sascha432/pizero-doorspy/stl/doorspy-housing-led-cover.stl

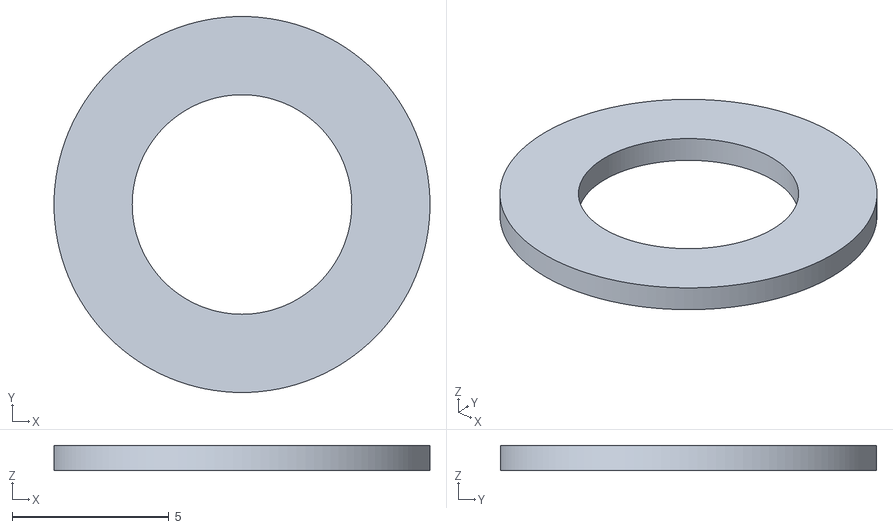
[picture p2: CAD file, 2026-10-21]
stl/doorspy-housing-led-cover.stl
12.0 x 12.0 x 0.8
