sascha432/pizero-doorspy/stl/doorspy-housing-backplate.stl

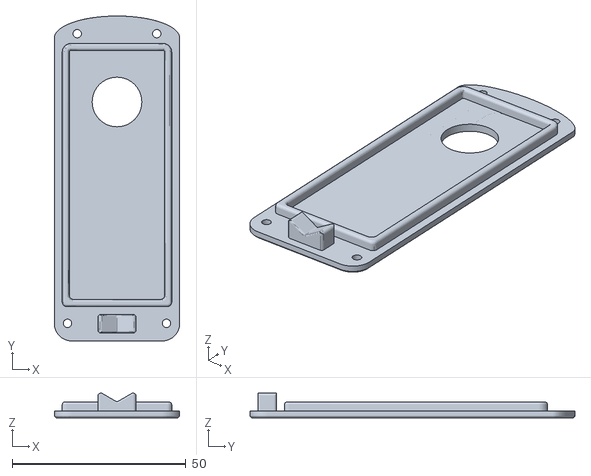
[picture p3: CAD file, 2026-10-21]
stl/doorspy-housing-backplate.stl
36.1 x 93.4 x 7.11
