sascha432/pizero-doorspy/stl/doorspy-housing-body.stl

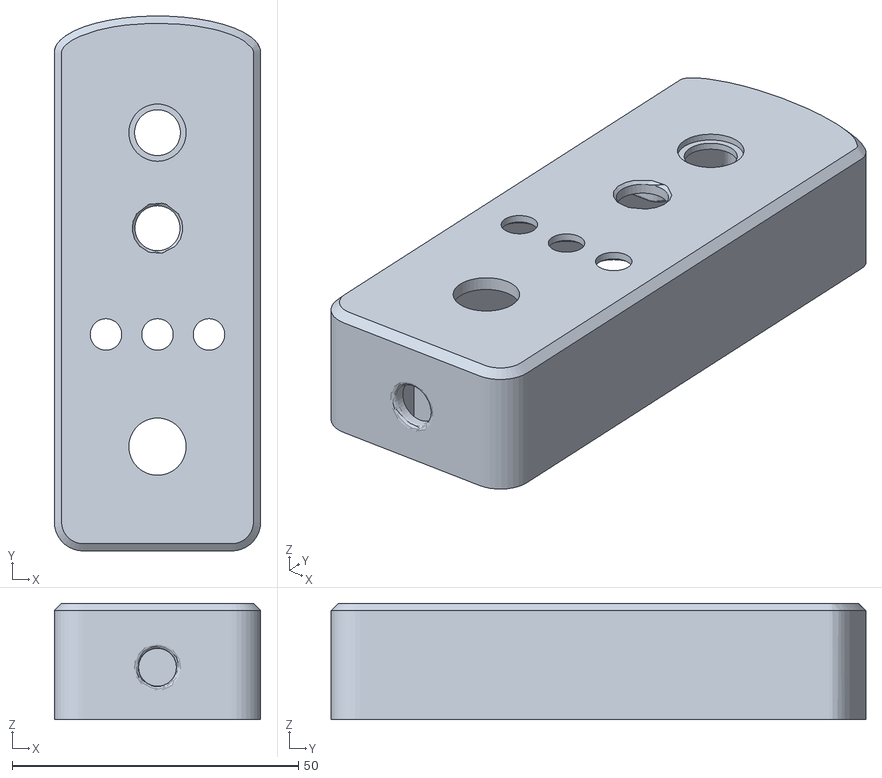
[picture p4: CAD file, 2026-10-21]
stl/doorspy-housing-body.stl
36.1 x 93.5 x 20.3
