sascha432/pizero-doorspy/stl/doorspy-housing-cam-cover.stl

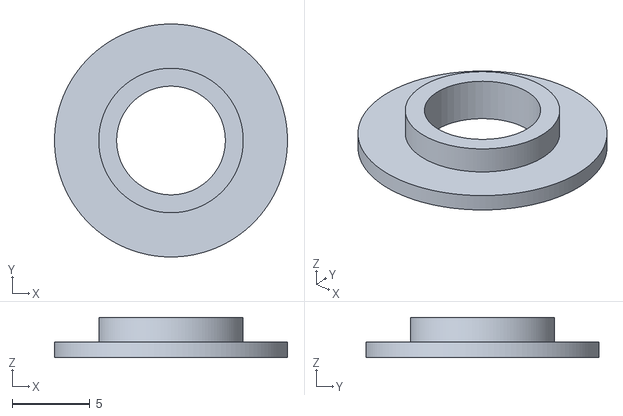
[picture p5: CAD file, 2026-10-21]
stl/doorspy-housing-cam-cover.stl
15.0 x 15.0 x 2.60
