sascha432/pizero-doorspy/stl/peephole-hollow-bolt-M12-nut.stl

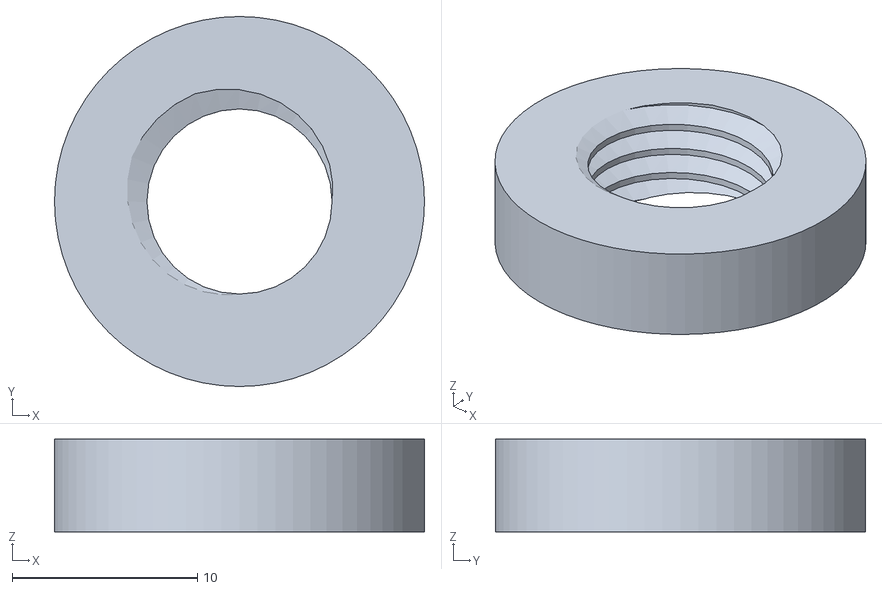
[picture p6: CAD file, 2026-10-21]
stl/peephole-hollow-bolt-M12-nut.stl
20.0 x 20.0 x 5.00
