sascha432/pizero-doorspy/stl/peephole-hollow-bolt-M12-56mm.stl

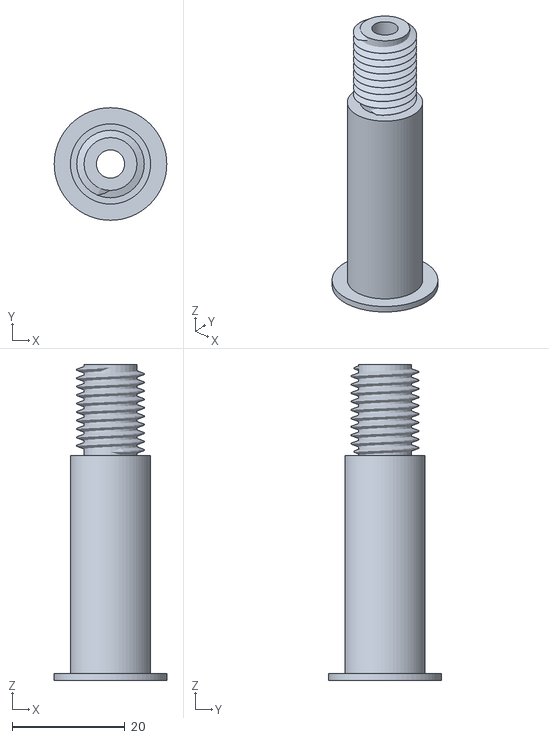
[picture p7: CAD file, 2026-10-21]
stl/peephole-hollow-bolt-M12-56mm.stl
20.0 x 20.0 x 56.1
