sascha432/pizero-doorspy/(commit log)

2026-10-21 doorspy: Pi Zero W door camera with web UI, Frigate gating and lights
    Camera service (Picamera2 -> H.264 to MediaMTX, MJPEG/snapshot on :8080 with
    Basic auth), web UI on :8443 (HTTPS, live image controls, stream settings,
    lights, Frigate modes, system), doorspy-io (power LED, WS2812 status indicator,
    button, PIR, per-function Frigate gate incl. the camera-enable switch, CPU
    temperature on MQTT), installer, Frigate config for the Pi 4, docs, case STLs.
    [doorspy-housing-backplate.stl, doorspy-housing-body.stl, doorspy-housing-cam-cover.stl, doorspy-housing-led-cover.stl, peephole-hollow-bolt-M12-56mm.stl, peephole-hollow-bolt-M12-nut.stl]
2026-10-21 README: drop done roadmap items (case, mounting, DHCP reservation)
2026-10-21 README: photo of the printed case
2026-10-21 camera: keep the MJPEG encoder running 300 s after the last client
    hassctrl tile previews open /api/stream.mjpeg once a minute for one
    frame. Starting and stopping the hardware encoder that often made the
    VC4 codec driver oops after a few hundred cycles and leak CMA memory,
    which took every stream down until a reboot.
    [camera.py]
2026-10-25 RTSP and WebRTC need the stream login
    MediaMTX served :8554 and :8889 to anyone on the LAN. It now asks
    camera.py about every client (authMethod: http): reading needs the
    stream or admin login, as on :8080, and only localhost may publish.
    The check runs in a child process on 127.0.0.1:8081, because PyAV
    holds the GIL while it connects the RTSP output that MediaMTX is
    asking about, so an in-process handler timed out and the publish
    was refused.
    Frigate pulls with the login from /opt/frigate/.env (default
    guest / password); docs/pi4.md covers updating an existing install.
